mizutanilab/BluetoothDialsRS232C/pics/overall.png

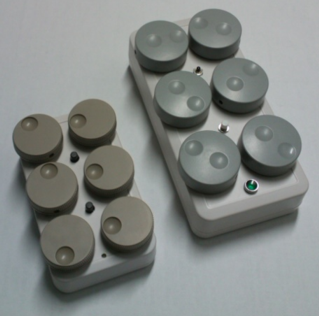
pics/overall.png
