mizutanilab/BluetoothDialsRS232C/(list of files, drawings)

Other design files:
gerber/boardR6_190226.pcb
gerber/boardR6_190329.pcb
